aritra1911/hourswitch/README.md

# Hour Switch
A relay operated switch which can switch between powering devices, each for a duration of 4 hours.

## Input
9 to 20 V DC, 1 A.

## TODO
- [ ] Make switching hours programmable via DIP switches.
