aritra1911/hourswitch/hour_switch.kicad_pcb

## KiCad design hour_switch.kicad_pcb (2020-12-30)

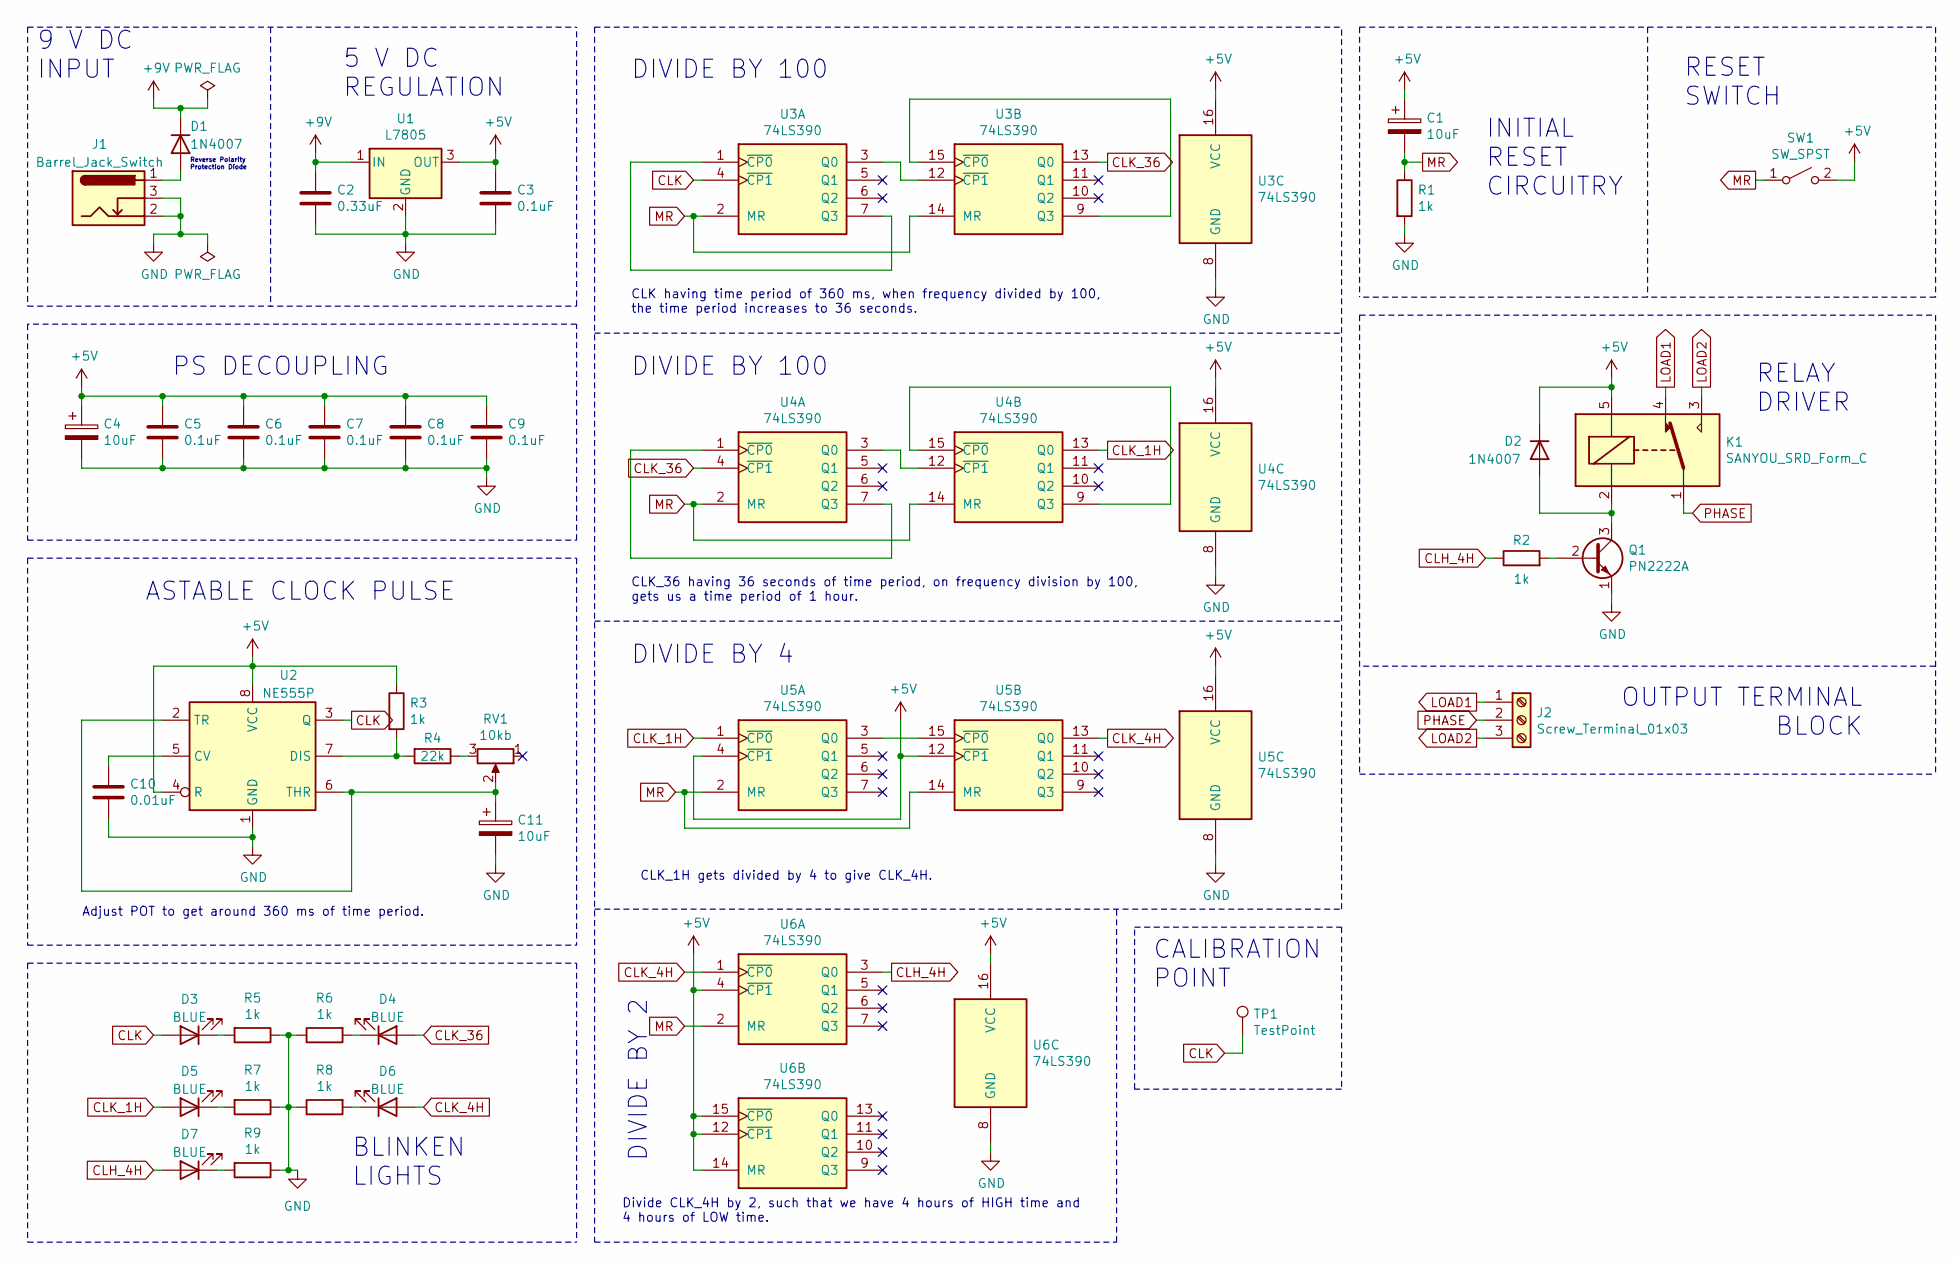
[picture p1: schematic hour_switch.sch, Hour Switch]

Parts:
C1, C4, C11: 10uF; CP_Radial_D5.0mm_P2.00mm
C2: 0.33uF; C_Rect_L24.0mm_W7.0mm_P22.50mm_MKT
C3, C5, C6, C7, C8, C9: 0.1uF; C_1206_3216Metric
C10: 0.01uF; C_Disc_D3.0mm_W2.0mm_P2.50mm
D1, D2: 1N4007; D_5W_P10.16mm_Horizontal
D3, D4, D5, D6, D7: BLUE; LED_1206_3216Metric
J1: Barrel_Jack_Switch; BarrelJack_Horizontal
J2: Screw_Terminal_01x03; TerminalBlock_Altech_AK300-3_P5.00mm
K1: SANYOU_SRD_Form_C; Relay_SPDT_SANYOU_SRD_Series_Form_C
Q1: PN2222A; TO-92_Inline_Wide
R1, R2, R3, R5, R6, R7, R8, R9: 1k; R_1206_3216Metric
R4: 22k; R_Axial_DIN0207_L6.3mm_D2.5mm_P10.16mm_Horizontal
RV1: 10kb; Potentiometer_Bourns_3386P_Vertical
SW1: SW_SPST; SW_PUSH_6mm_H4.3mm
TP1: TestPoint; TestPoint_Bridge_Pitch2.54mm_Drill1.0mm
U1: L7805; TO-220-3_Horizontal_TabDown_NoDrill
U2: NE555P; DIP-8_W7.62mm_Socket_LongPads
U3, U4, U5, U6: 74LS390; DIP-16_W7.62mm_Socket_LongPads

Connections:
+5V: C1.1, C3.1, C4.1, C5.1, C6.1, C7.1, C8.1, C9.1, D2.1 (K), K1.5, R3.1, SW1.2 (B), U1.3 (OUT), U2.4 (R), U2.8 (VCC), U3.16 (VCC), U4.16 (VCC), U5.4 (~CP1), U5.12 (~CP1), U5.16 (VCC), U6.4 (~CP1), U6.12 (~CP1), U6.14 (MR), U6.15 (~CP0), U6.16 (VCC)
+9V: C2.1, D1.1 (K), U1.1 (IN)
CLH_4H: D7.2 (A), R2.1, U6.3 (Q0)
CLK: D3.2 (A), TP1.1, U2.3 (Q), U3.4 (~CP1)
CLK_1H: D5.2 (A), U4.13 (Q0), U5.1 (~CP0)
CLK_4H: D6.2 (A), U5.13 (Q0), U6.1 (~CP0)
CLK_36: D4.2 (A), U3.13 (Q0), U4.4 (~CP1)
GND: C2.2, C3.2, C4.2, C5.2, C6.2, C7.2, C8.2, C9.2, C10.2, C11.2, J1.2, J1.3, Q1.1 (E), R1.2, R5.1, R6.1, R7.1, R8.1, R9.1, U1.2 (GND), U2.1 (GND), U3.8 (GND), U4.8 (GND), U5.8 (GND), U6.8 (GND)
LOAD1: J2.1, K1.4
LOAD2: J2.3, K1.3
MR: C1.2, R1.1, SW1.1 (A), U3.2 (MR), U3.14 (MR), U4.2 (MR), U4.14 (MR), U5.2 (MR), U5.14 (MR), U6.2 (MR)
unnamed: C10.1, U2.5 (CV)
unnamed: C11.1, RV1.2, U2.2 (TR), U2.6 (THR)
unnamed: D1.2 (A), J1.1
unnamed: D2.2 (A), K1.2, Q1.3 (C)
unnamed: D3.1 (K), R5.2
unnamed: D4.1 (K), R6.2
unnamed: D5.1 (K), R7.2
unnamed: D6.1 (K), R8.2
unnamed: D7.1 (K), R9.2
unnamed: Q1.2 (B), R2.2
unnamed: R3.2, R4.2, U2.7 (DIS)
unnamed: R4.1, RV1.3
unnamed: U3.1 (~CP0), U3.7 (Q3)
unnamed: U3.3 (Q0), U3.12 (~CP1)
unnamed: U3.9 (Q3), U3.15 (~CP0)
unnamed: U4.1 (~CP0), U4.7 (Q3)
unnamed: U4.3 (Q0), U4.12 (~CP1)
unnamed: U4.9 (Q3), U4.15 (~CP0)
unnamed: U5.3 (Q0), U5.15 (~CP0)
PHASE: J2.2, K1.1

Notes on the sheet:
DIVIDE BY 2
RELAY DRIVER
DIVIDE BY 100
DIVIDE BY 4
ASTABLE CLOCK PULSE
Adjust POT to get around 360 ms of time period.
PS DECOUPLING
INITIAL RESET CIRCUITRY
5 V DC REGULATION
9 V DC INPUT
OUTPUT TERMINAL BLOCK
BLINKEN LIGHTS
CLK having time period of 360 ms, when frequency divided by 100, the time period increases to 36 seconds.
CLK_36 having 36 seconds of time period, on frequency division by 100, gets us a time period of 1 hour.
RESET SWITCH
CALIBRATION POINT
Reverse Polarity Protection Diode
CLK_1H gets divided by 4 to give CLK_4H.
Divide CLK_4H by 2, such that we have 4 hours of HIGH time and 4 hours of LOW time.

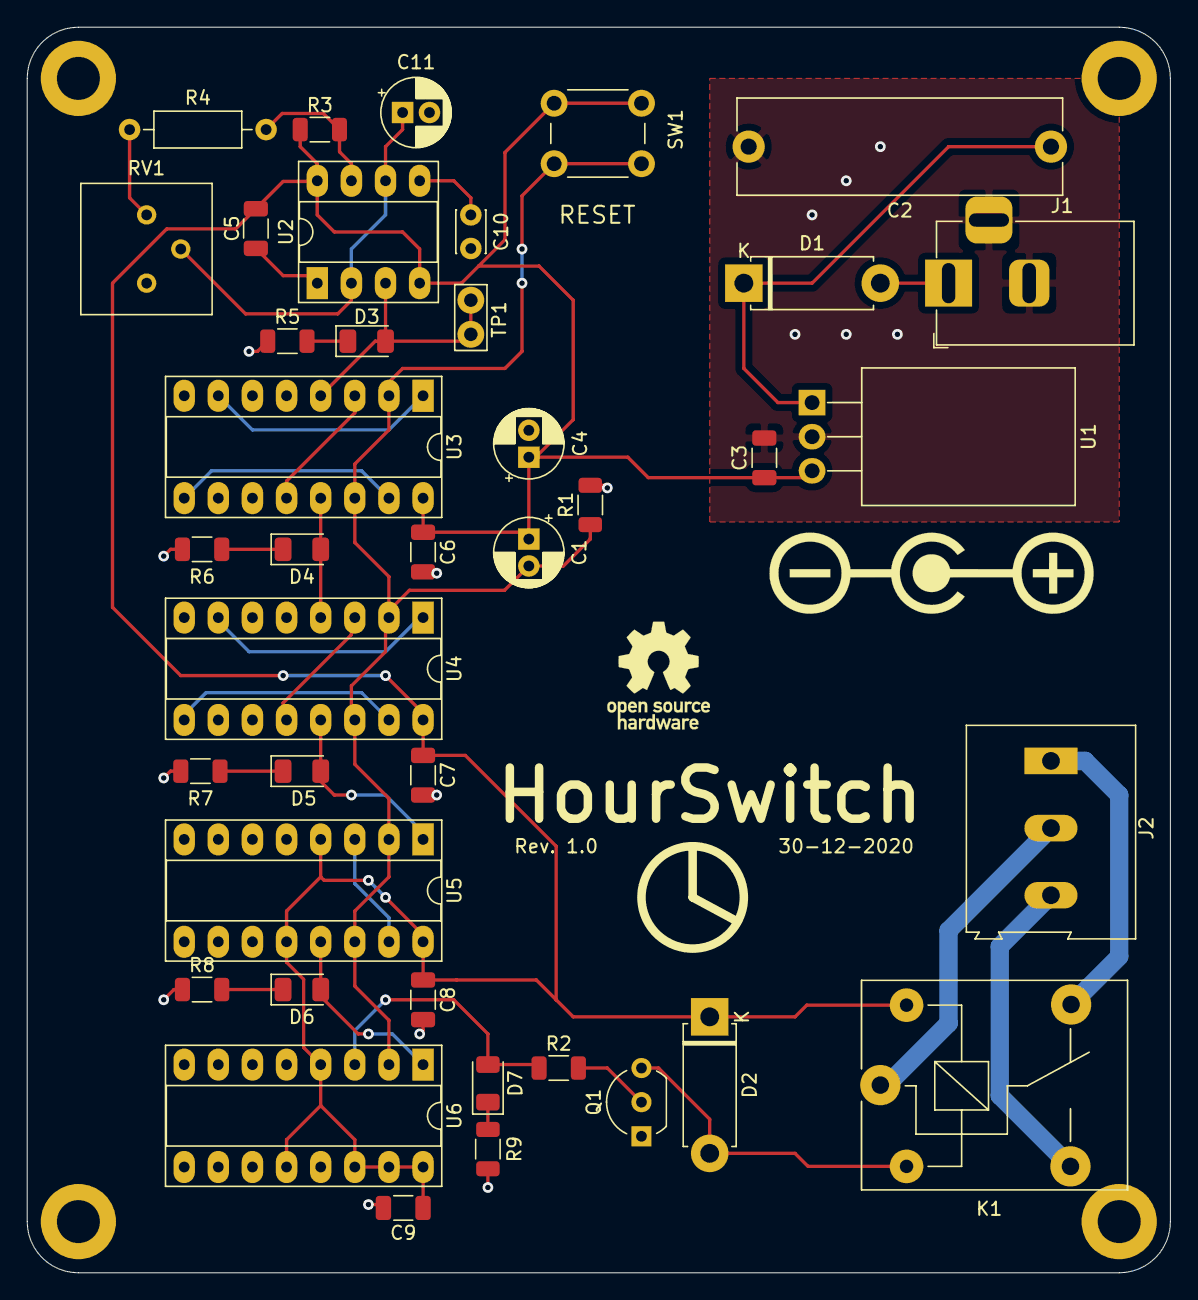
[picture p2: board hour_switch.kicad_pcb from above]

Board: 2 copper layers, 85.1 x 92.7 mm, 40 parts (0 on the bottom side), 31 nets.
